Adamg159/powerunit-research/photos/2026-08-15-heatshrink-bracket-testers-buzzers.jpg

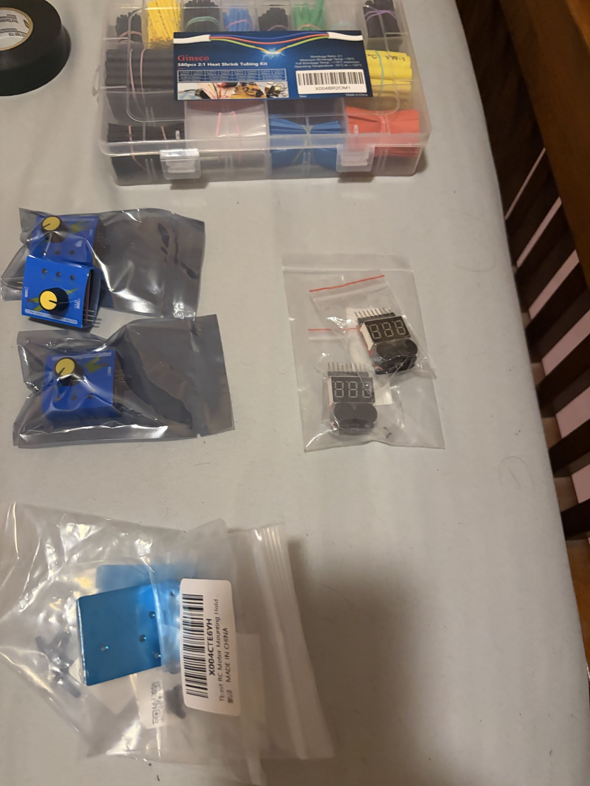
photos/2026-08-15-heatshrink-bracket-testers-buzzers.jpg
