Adamg159/powerunit-research/photos/2026-07-24-electronics-unboxing.jpg

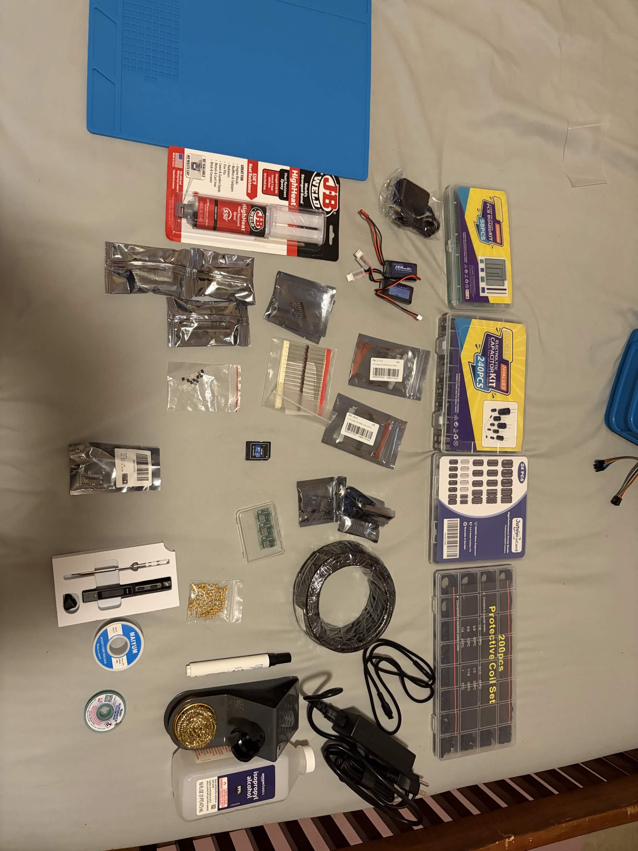
photos/2026-07-24-electronics-unboxing.jpg
