Adamg159/powerunit-research/README.md

# PowerUnit Research

Working repository for a 1/10-scale hybrid RC powertrain: a Toyan FS-L200AC 7cc
twin-cylinder four-stroke paired with a crank-mounted electric motor-generator
(F1 MGU-K style), managed by ESP32-based telemetry and energy management —
finishing in a self-designed 3D-printed chassis with instrumented aero. (A custom
ignition-timing ECU is a deferred stretch goal.)

Synced between desktop PC and laptop via this repo. Pull before working, push after.

**Status (2026-08-05):** engine on backorder until late August; build re-sequenced
to work around it (steering, MGU-K electrical, firmware, transmission, chassis
packaging, bench surrogate rig). See [CLAUDE.md](CLAUDE.md) for the governing plan.

## Contents

| File | What it is |
|---|---|
| [CLAUDE.md](CLAUDE.md) | Governing project context — architecture, current staged plan, decisions, open questions |
| [01-feasibility-proposal.html](01-feasibility-proposal.html) | Document 1 — feasibility assessment, three-phase plan, risks, budget |
| [02-phase1-status-and-arrival-plan.html](02-phase1-status-and-arrival-plan.html) | Document 2 — Phase 1 orders, arrival checklists, telemetry bill of materials |
| [03-build-companion.html](03-build-companion.html) | Document 3 — system walkthrough, wiring reference, EMI rules, study guide |
| [BUILD-LOG.md](BUILD-LOG.md) | Running log of progress, problems, and fixes — the portfolio deliverable |

Firmware source, wiring diagrams, and telemetry data will be added as the build progresses.
