Adamg159/powerunit-research/photos/2026-08-15-bench-set-all-items.jpg

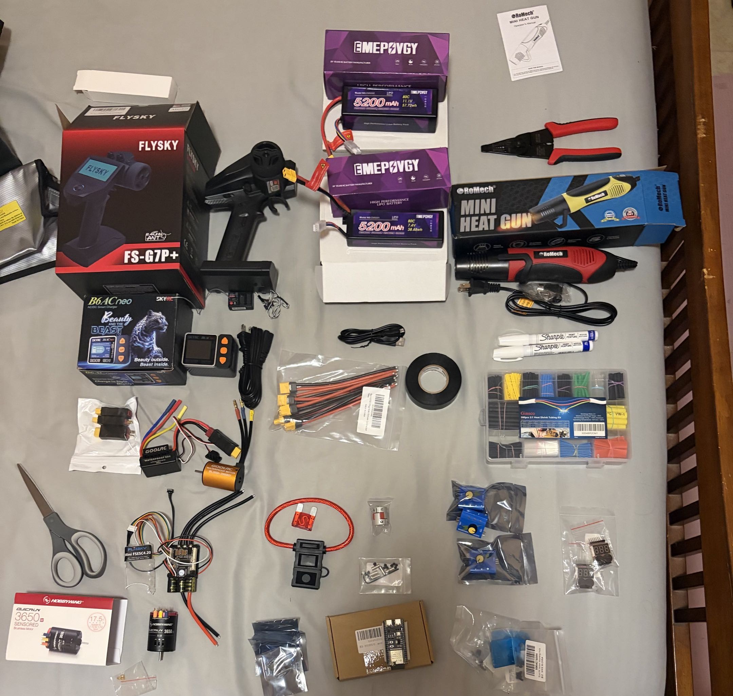
photos/2026-08-15-bench-set-all-items.jpg
