Adamg159/powerunit-research/photos/2026-08-15-charger-and-surrogate-combo.jpg

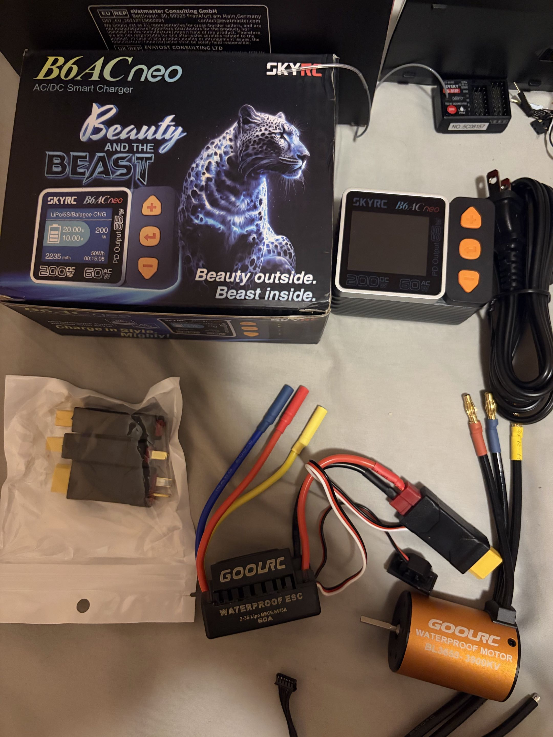
photos/2026-08-15-charger-and-surrogate-combo.jpg
