Adamg159/powerunit-research/photos/2026-08-15-esp32s3-bucks-fuse-coupler-sleeves.jpg

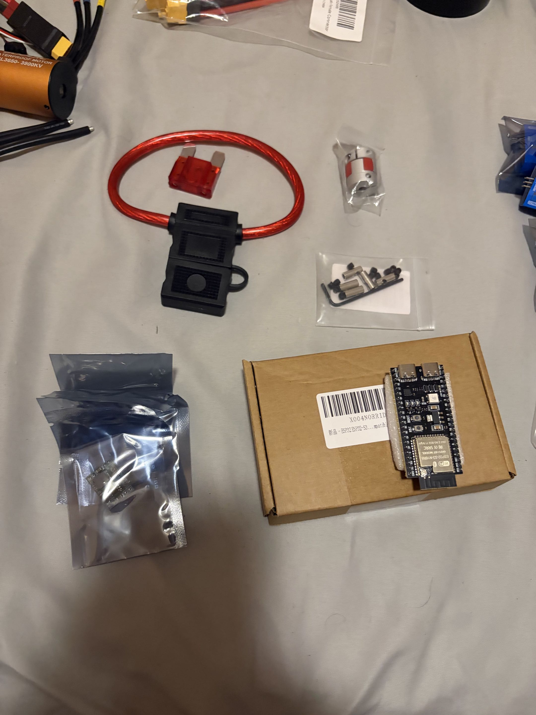
photos/2026-08-15-esp32s3-bucks-fuse-coupler-sleeves.jpg
