Adamg159/powerunit-research/photos/2026-08-15-heat-gun-stripper-tools.jpg

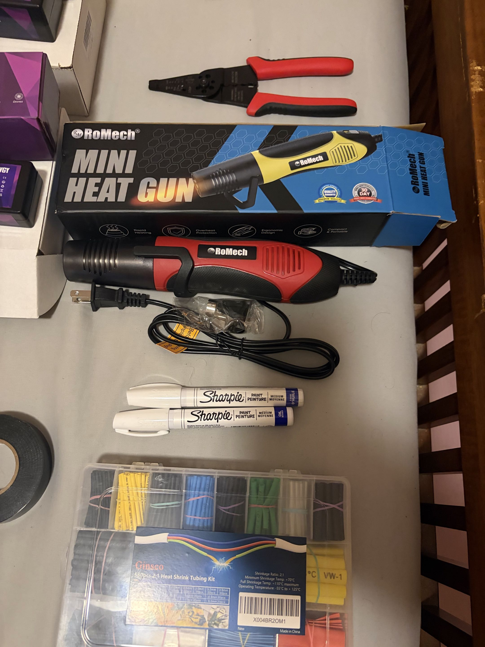
photos/2026-08-15-heat-gun-stripper-tools.jpg
