Adamg159/powerunit-research/photos/2026-08-15-lipo-packs-2s-and-3s.jpg

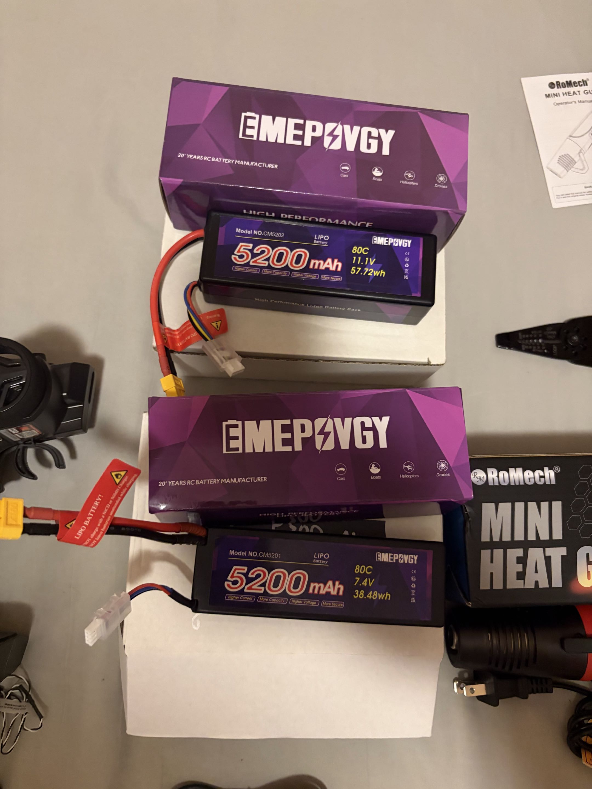
photos/2026-08-15-lipo-packs-2s-and-3s.jpg
