Adamg159/powerunit-research/photos/2026-08-15-lipo-safety-bags.jpg

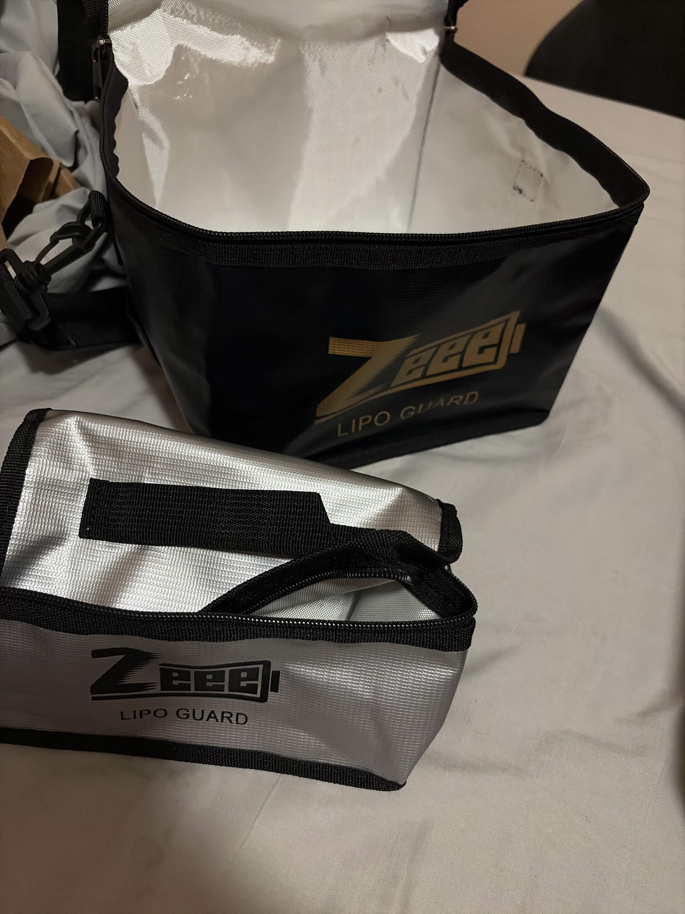
photos/2026-08-15-lipo-safety-bags.jpg
