Adamg159/powerunit-research/photos/2026-08-15-mgu-k-motor-and-vesc.jpg

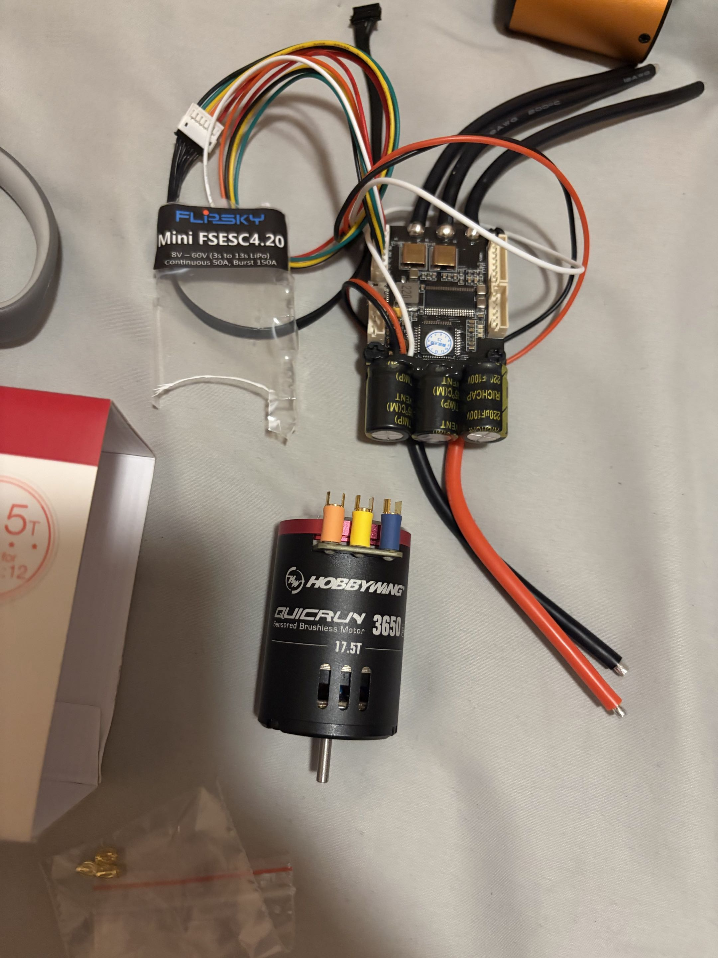
photos/2026-08-15-mgu-k-motor-and-vesc.jpg
