Adamg159/powerunit-research/photos/2026-08-15-radio-fs-g7p-and-receiver.jpg

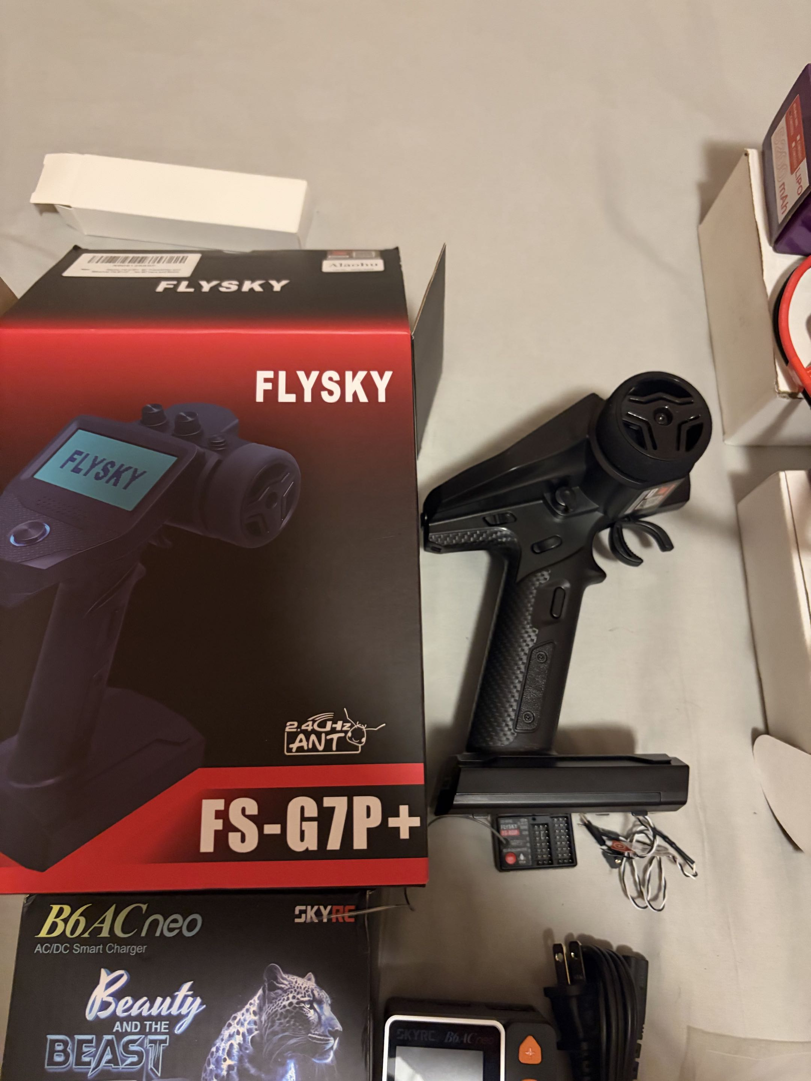
photos/2026-08-15-radio-fs-g7p-and-receiver.jpg
