Adamg159/powerunit-research/photos/2026-08-16-both-shafts-d-flats.jpg

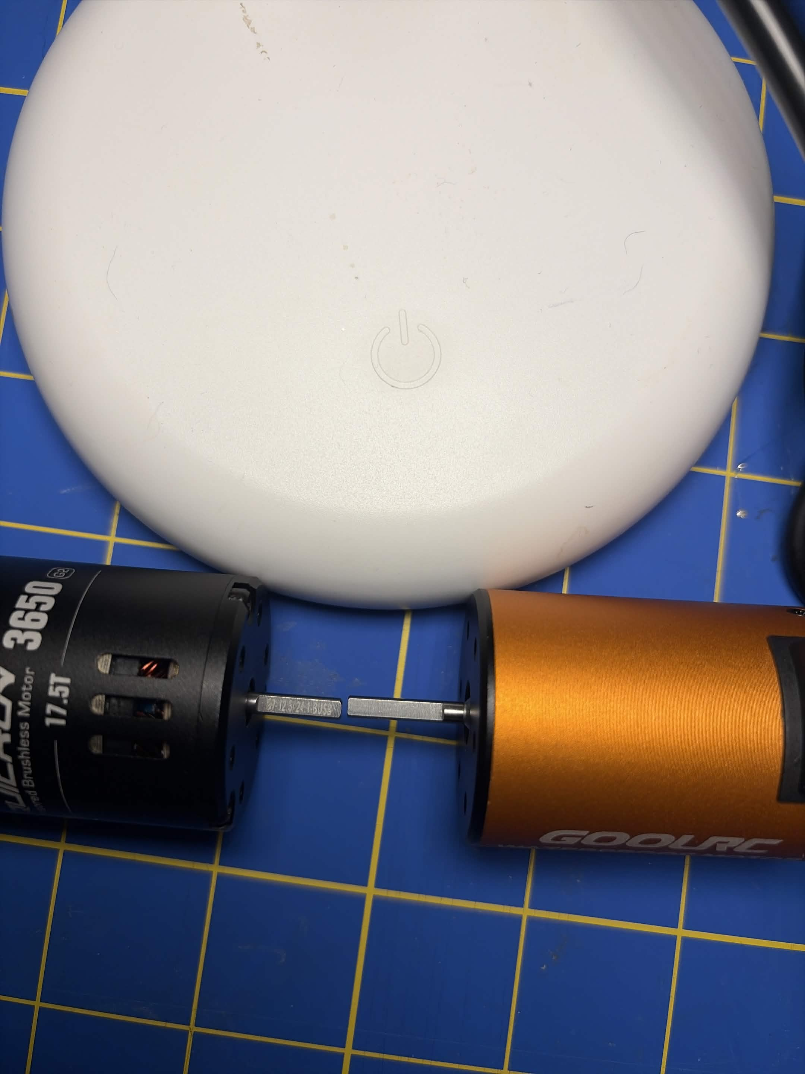
photos/2026-08-16-both-shafts-d-flats.jpg
