Adamg159/powerunit-research/photos/2026-08-16-first-3s-charge.jpg

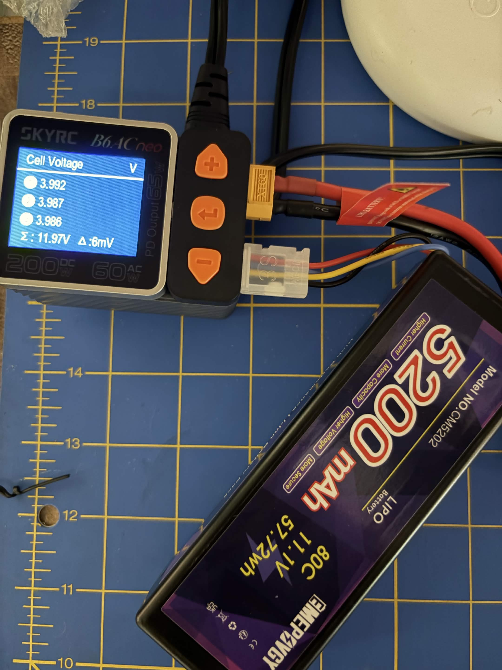
photos/2026-08-16-first-3s-charge.jpg
