Adamg159/powerunit-research/photos/2026-08-16-fs-r11p-top-labels.jpg

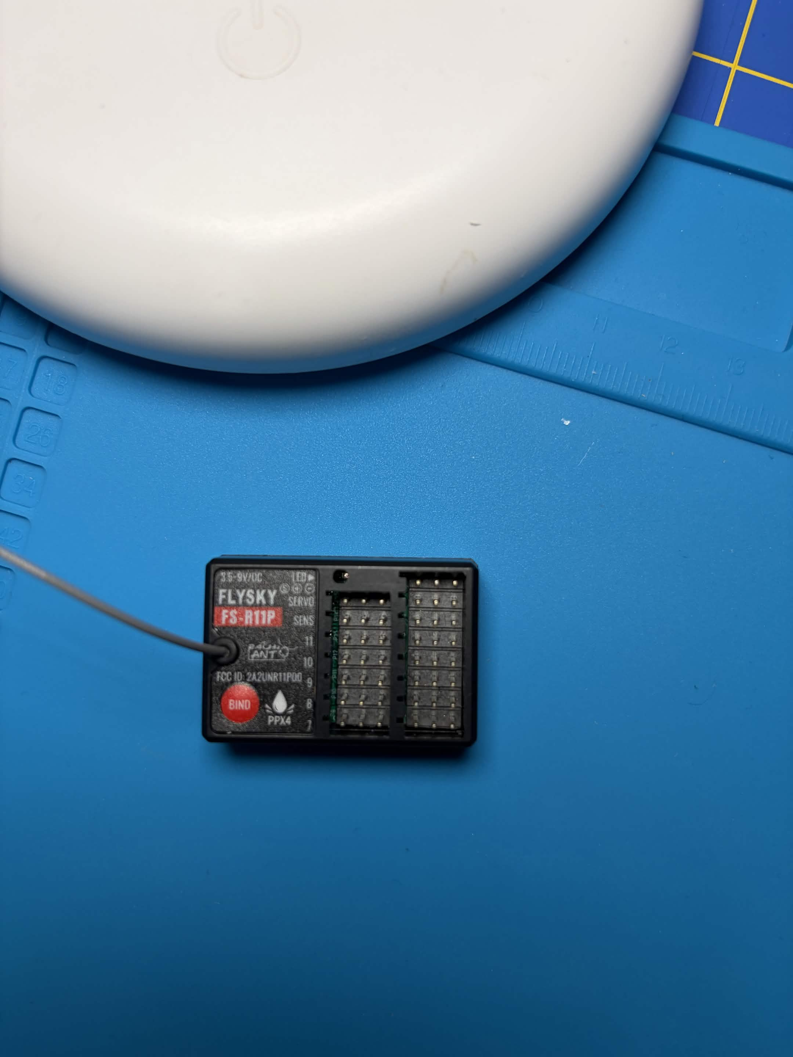
photos/2026-08-16-fs-r11p-top-labels.jpg
