Adamg159/powerunit-research/photos/2026-08-16-fuse-holder-wire-crosssection.jpg

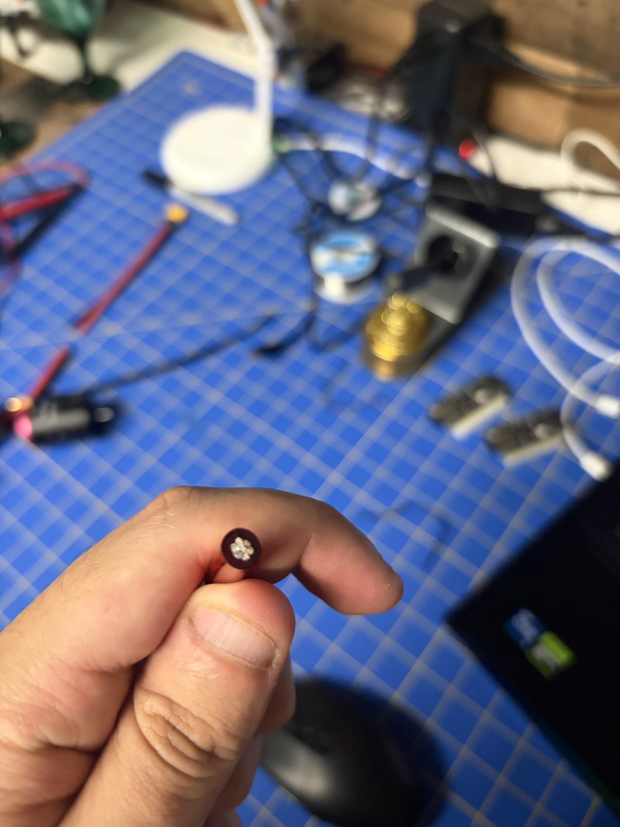
photos/2026-08-16-fuse-holder-wire-crosssection.jpg
