Adamg159/powerunit-research/photos/2026-08-16-motor-bracket-fitted-angled.jpg

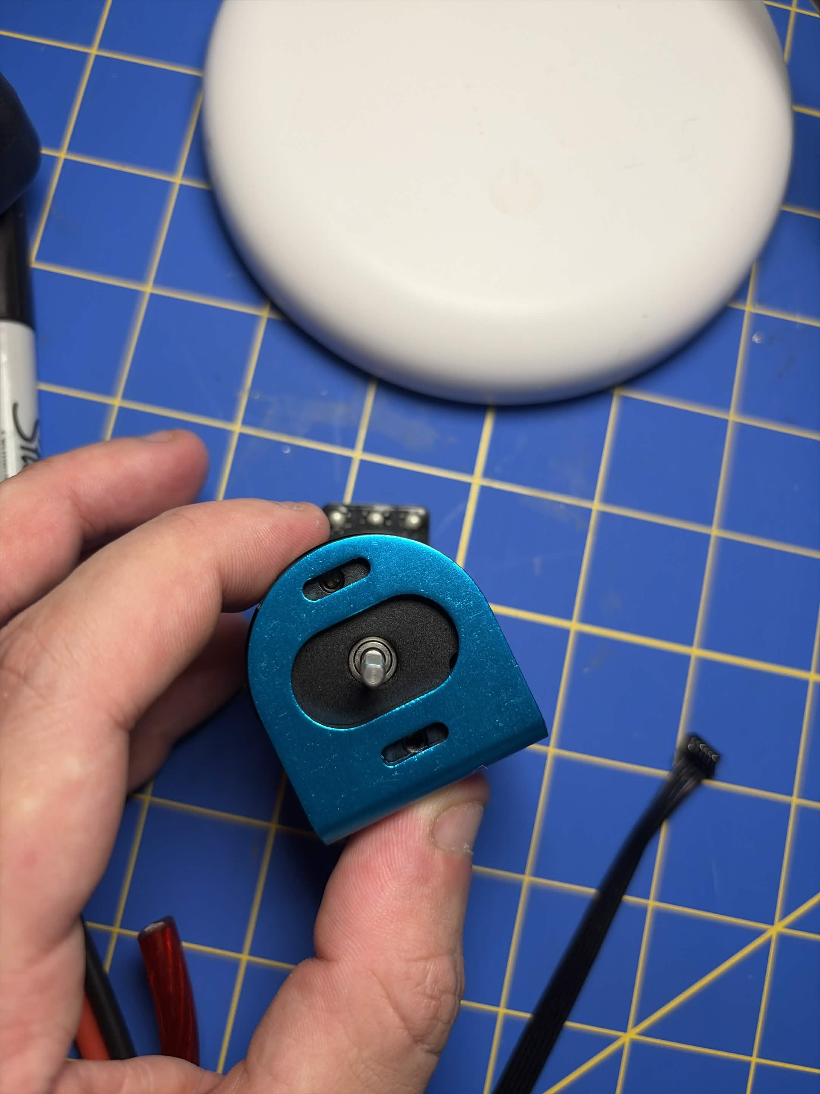
photos/2026-08-16-motor-bracket-fitted-angled.jpg
