Adamg159/powerunit-research/photos/2026-08-16-motor-can-label-and-bullets.jpg

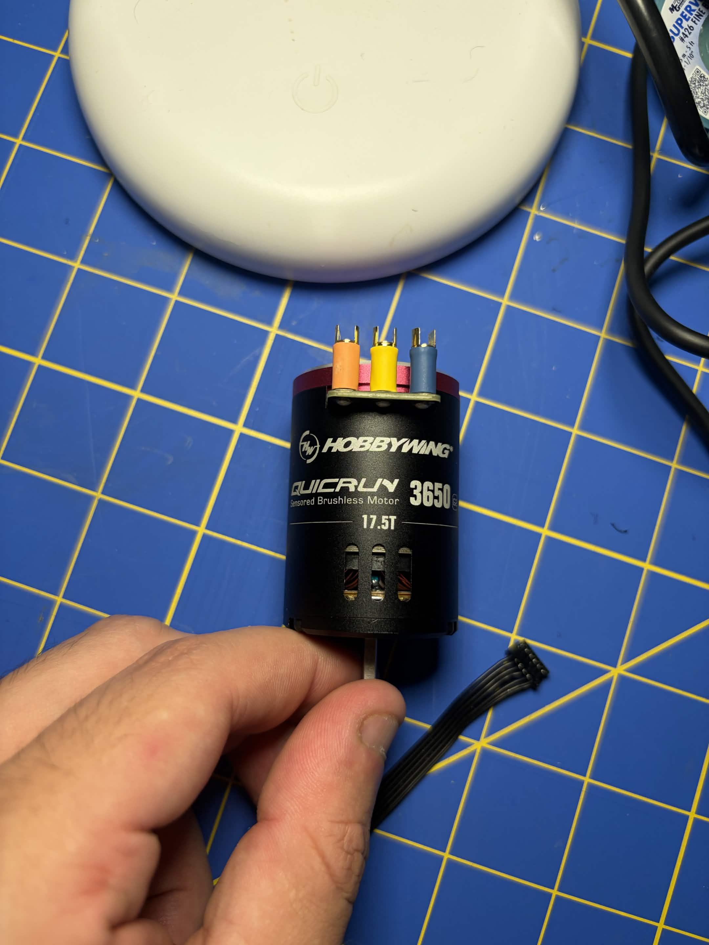
photos/2026-08-16-motor-can-label-and-bullets.jpg
