Adamg159/powerunit-research/photos/2026-08-16-motor-can-serial.jpg

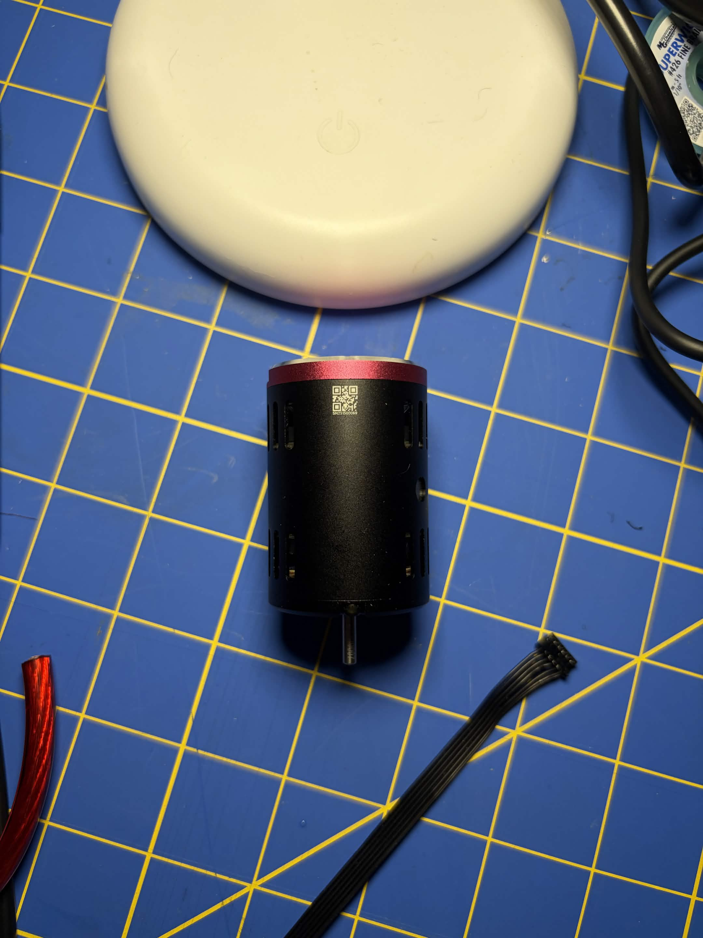
photos/2026-08-16-motor-can-serial.jpg
