Adamg159/powerunit-research/photos/2026-08-16-motor-endbell-abc-labels.jpg

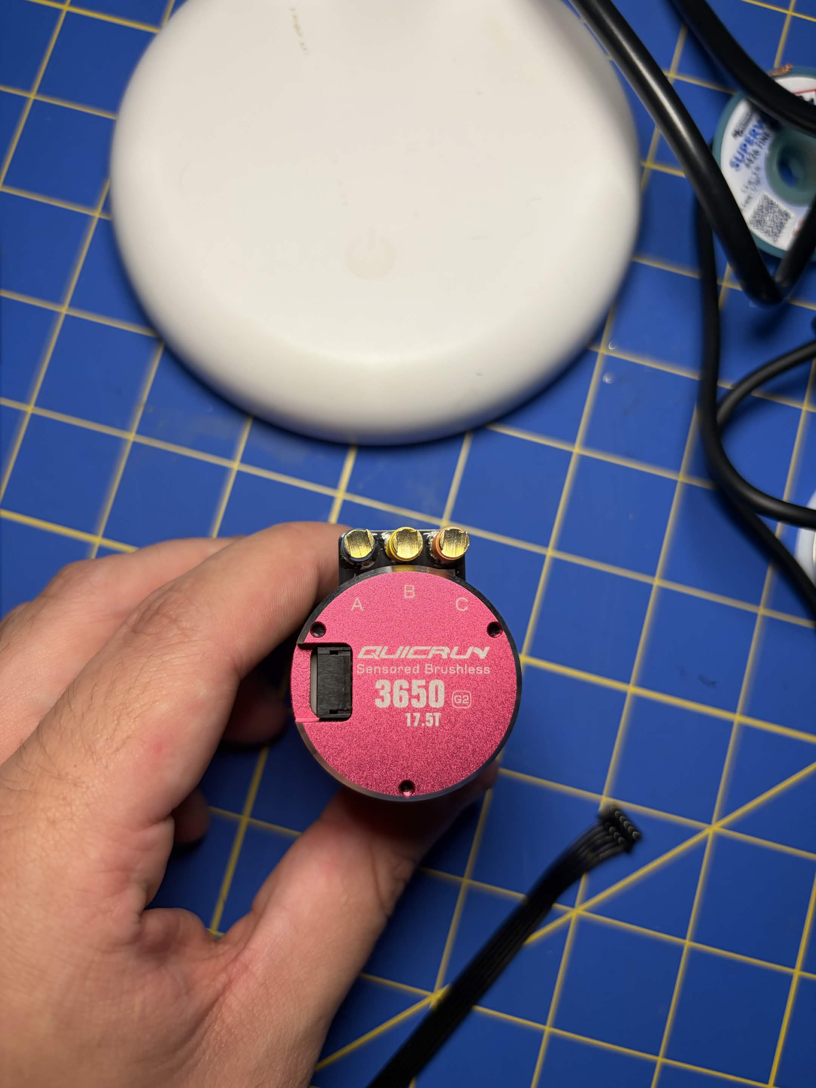
photos/2026-08-16-motor-endbell-abc-labels.jpg
