Adamg159/powerunit-research/photos/2026-08-16-motor-front-mounting-face.jpg

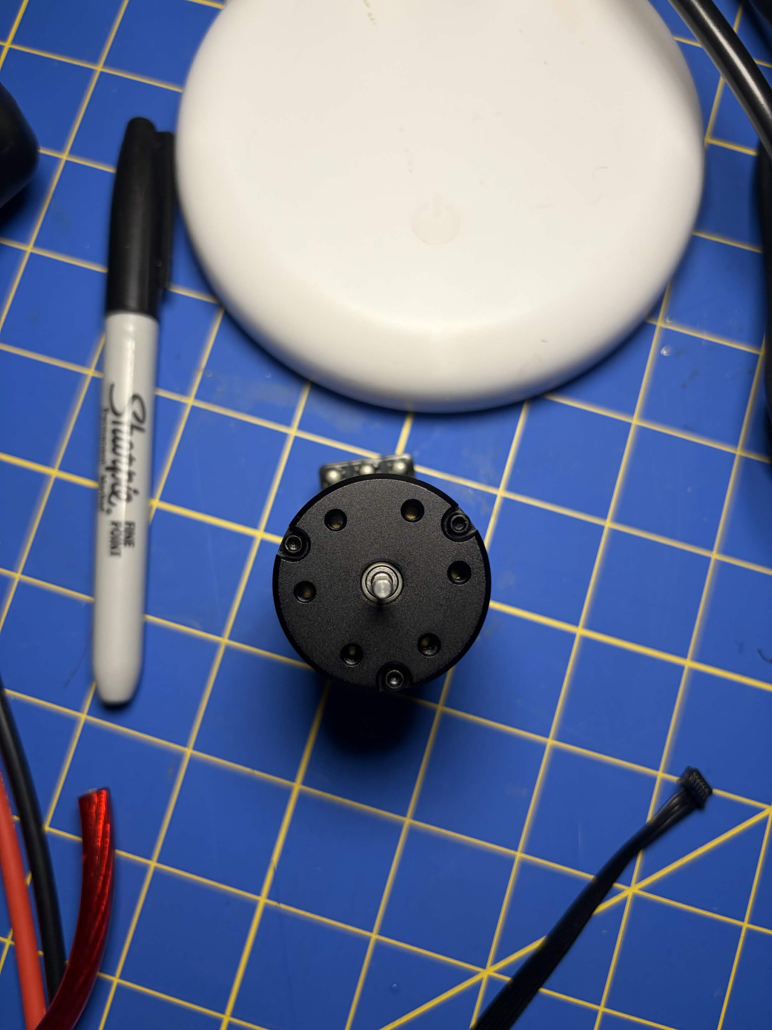
photos/2026-08-16-motor-front-mounting-face.jpg
