Adamg159/powerunit-research/photos/2026-08-16-motor-side-shaft-end.jpg

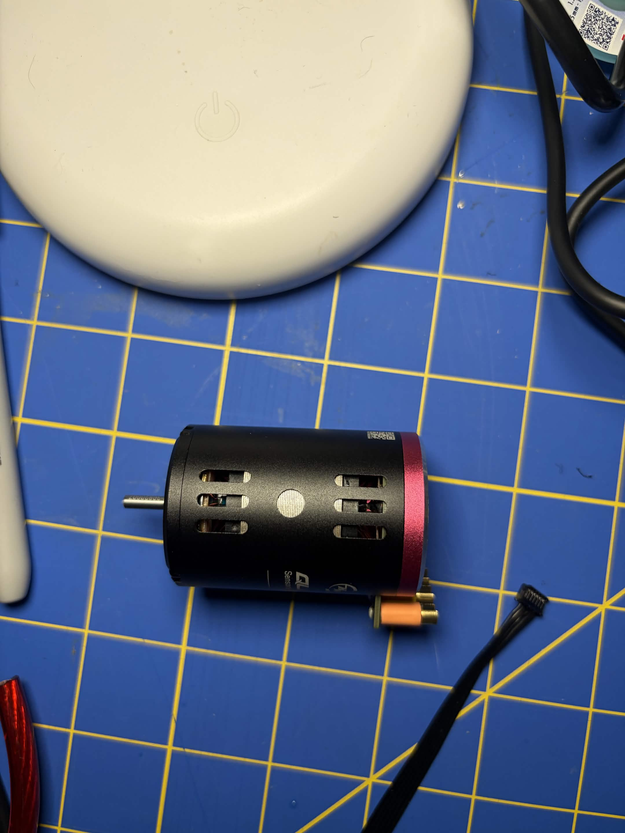
photos/2026-08-16-motor-side-shaft-end.jpg
