Adamg159/powerunit-research/photos/2026-08-16-sensor-cable-mated-joint.jpg

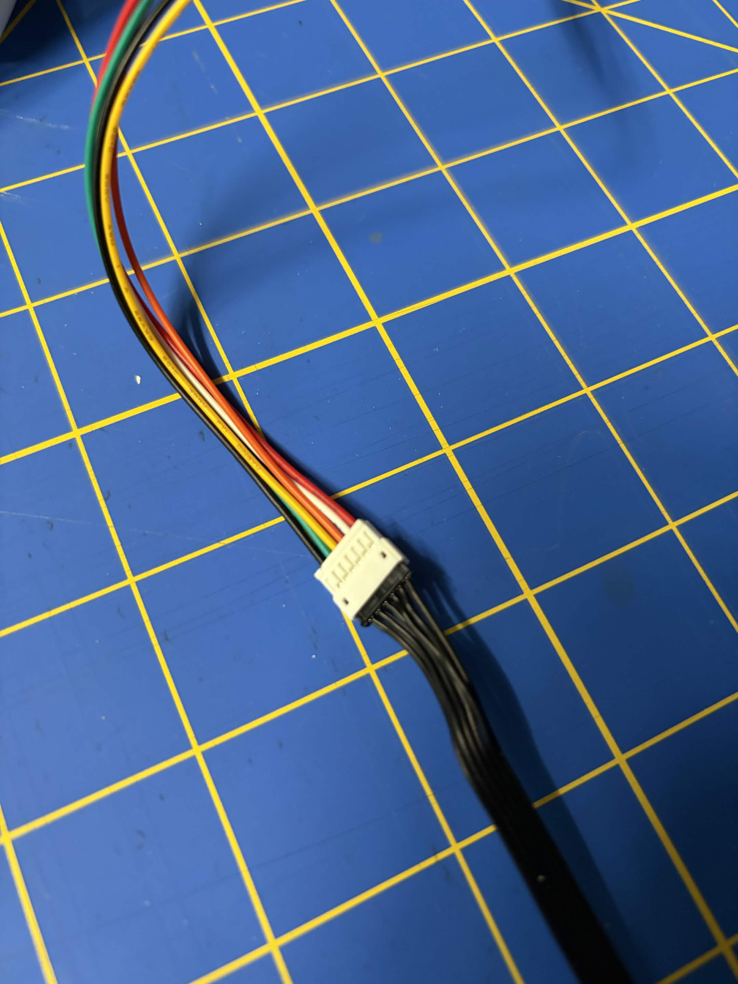
photos/2026-08-16-sensor-cable-mated-joint.jpg
