Adamg159/powerunit-research/photos/2026-08-16-sensor-path-full-chain.jpg

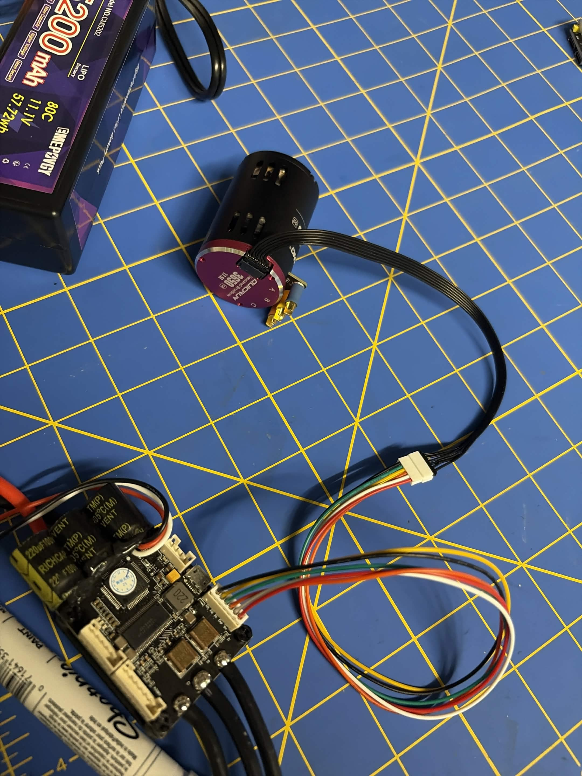
photos/2026-08-16-sensor-path-full-chain.jpg
