Adamg159/powerunit-research/photos/2026-08-16-sensor-path-motor-endbell.jpg

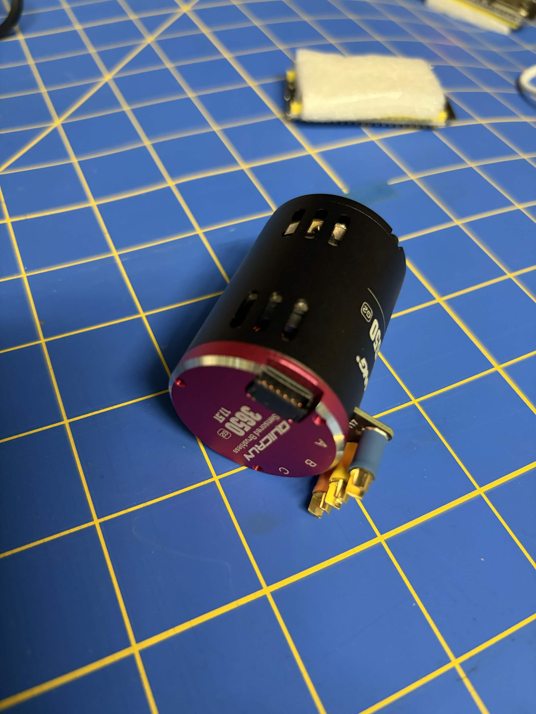
photos/2026-08-16-sensor-path-motor-endbell.jpg
