Adamg159/powerunit-research/photos/2026-08-16-vesc-ports-and-sensor-pigtail.jpg

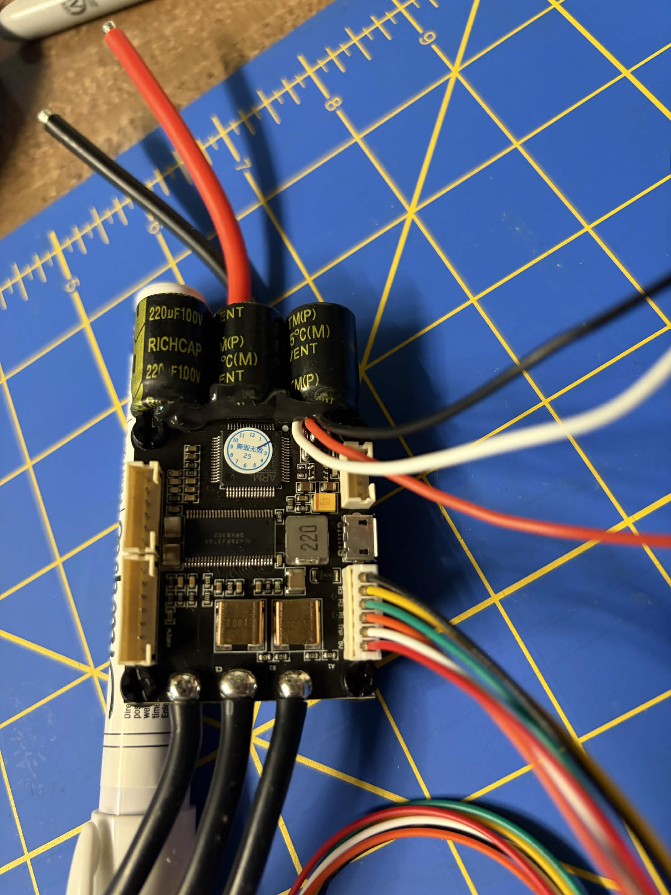
photos/2026-08-16-vesc-ports-and-sensor-pigtail.jpg
