Adamg159/powerunit-research/photos/2026-08-16-motor-manual-specs.jpg

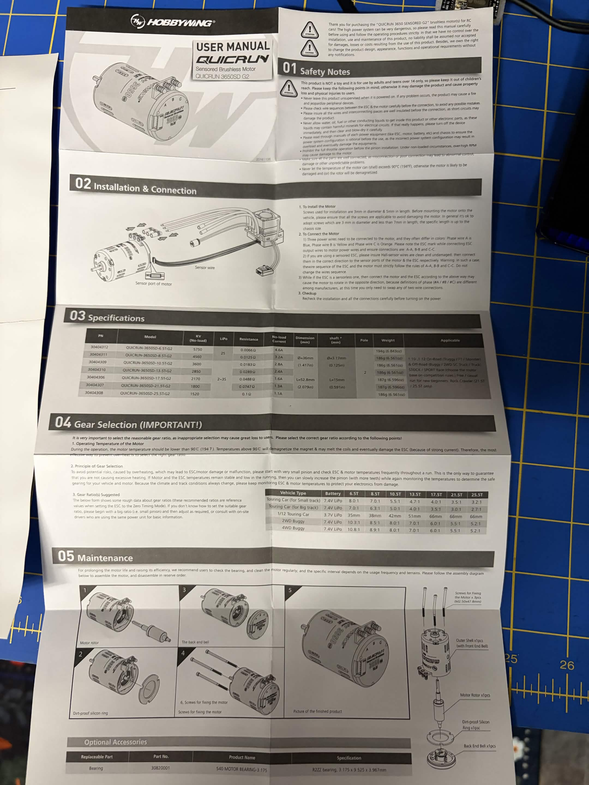
photos/2026-08-16-motor-manual-specs.jpg
