Adamg159/powerunit-research/photos/2026-08-16-power-path-pre-solder.jpg

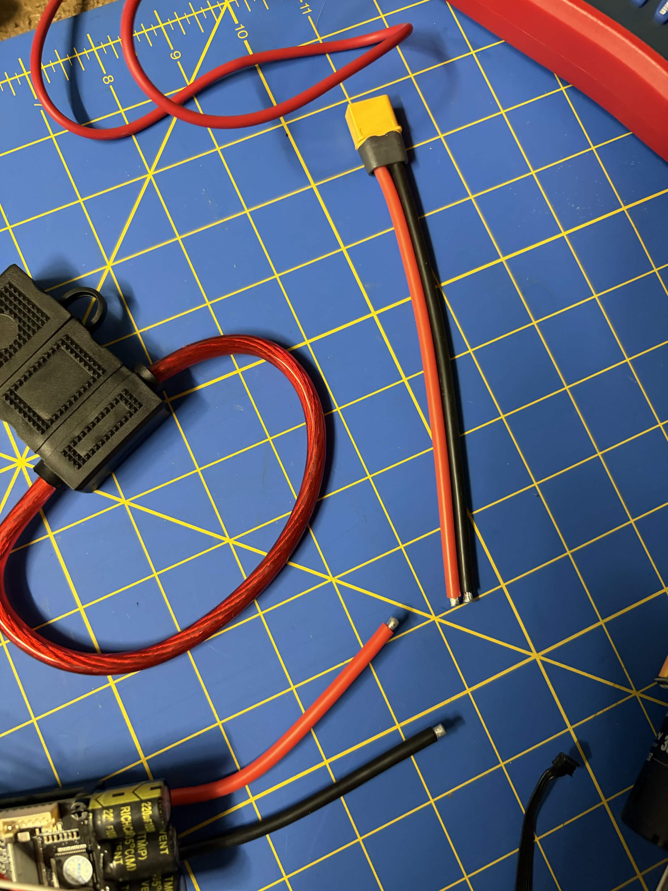
photos/2026-08-16-power-path-pre-solder.jpg
