Adamg159/powerunit-research/photos/2026-08-16-vesc-wiring-diagram.jpg

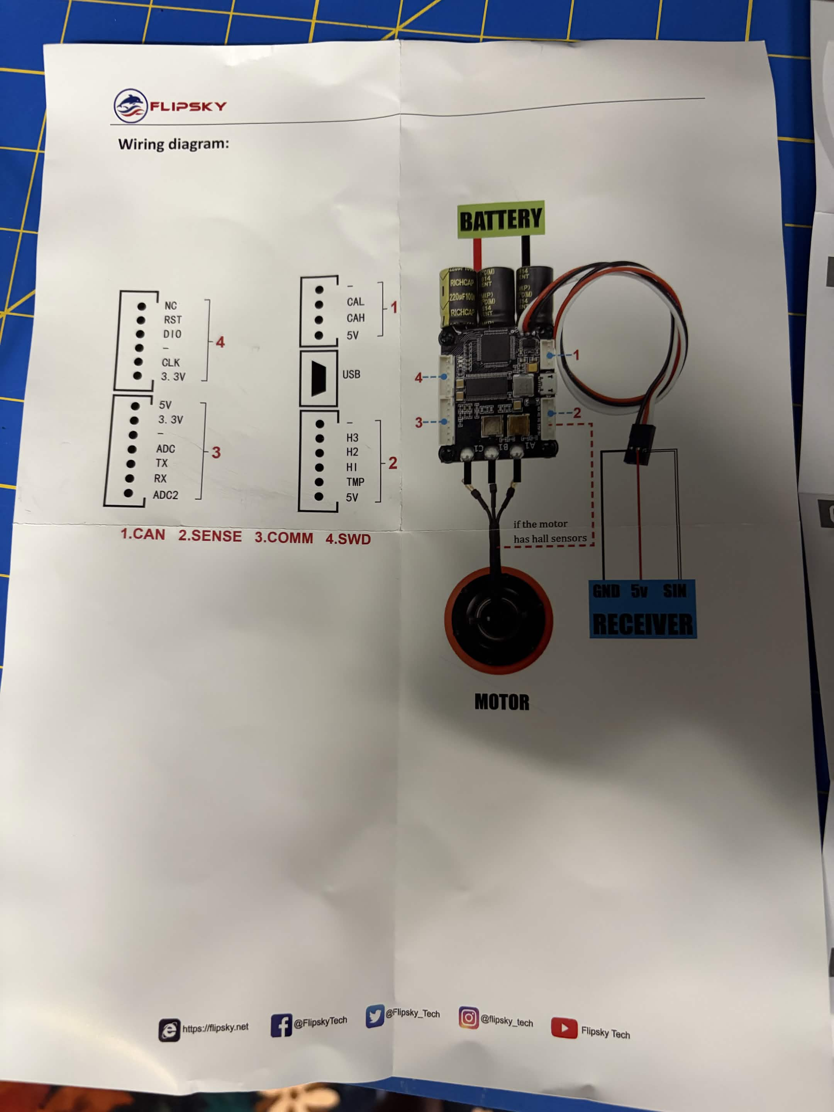
photos/2026-08-16-vesc-wiring-diagram.jpg
