Adamg159/powerunit-research/(commit log)

2026-07-25 Electronics arrival: all 3 ESP32s verified, arrival-test firmware added
    Arrival logged with delivery inventory (one MAX31855 and the SmCo magnets
    still in transit, neither blocking). All three ESP32 DevKits flashed and
    verified: genuine D0WD-V3, working WiFi, MACs logged for identification.
2026-07-25 Log multimeter gap: bucks blocked until it arrives
2026-07-25 Add clip leads to tooling order; note pigtail plan for buck setup
2026-07-26 Add sensor arrival-test sketches: MPU-6050, MAX31855, SD module, Hall
    All dependency-free (raw Wire/SPI or bundled SD lib), wiring documented
    in each header, clear PASS criteria over serial. Compile-verified.
    firmware/README.md indexes them with flash commands.
2026-07-26 Log JST-RCY pigtail order; battery connector identified
2026-07-26 Log SD module PASS: mounts at 10 MHz, write/append/read-back verified
    25 MHz failed on jumper wires as the sketch anticipated; the clock-ladder
    retry dropped to 10 MHz and mounted. Card reports 29.15 GB, matching the
    h2testw result.
    Also note the COM port is per-USB-port (COM8 this time, not COM4) and
    record the Arduino IDE board selection (ESP32 Dev Module).
2026-07-26 Log MPU-6050 PASS at 0x68; note default gyro range clips at 250 dps
    Accel magnitude 0.99-1.00 g at rest, gyro bias 1-3 dps, die temp ~28 C.
    AD0 pulls low on these GY-521 boards, so 0x68 needs no jumper.
    Also records two traps found along the way: the sketch prints a very
    plausible 36.5 C with nothing connected (Wire.read() returns -1 on an
    empty buffer), and the stock +/-250 dps full scale railed during hand
    handling and will saturate on a running engine.
2026-07-26 All 3 MPU-6050 boards soldered and verified; tick checklist item
    Headers soldered on all three GY-521 boards and each tested individually,
    all PASS at 0x68. Closes the arrival-checklist soldering item.
2026-07-26 Log MAX31855 PASS: cold junction 26.5 C, OC fault correctly set
    Fault register reads OC=1 with SCV=0 SCG=0 -- open circuit only, which is
    the expected result with no probe attached. The 2047.75 C reading is the
    14-bit field's positive rail, not data.
    Notes that the analog measurement path is still unverified; shorting T+
    to T- would exercise it before the washer thermocouples arrive.
2026-07-28 Log precision screwdriver + wire stripper/crimper orders
    Two bench tooling gaps found while setting up buck trim-pot tuning:
    - AXTH 25-in-1 precision screwdriver set (MP1584 pot needs ~1.5mm blade)
    - WGGE WG-015 wire stripper/crimper (20 AWG pigtails, 22-26 AWG sensor wire)
    Document 2 gains a "Bench hand tools" row plus the previously unrecorded
    JST-RCY pigtail line; document 3's buck checklist now spells out the full
    hookup.
2026-07-31 Log buck tuning: 2 of 3 MP1584s at ~5 V, third board fried; tick checklist
2026-07-31 Note cause of dead buck: accidental short during tuning
2026-08-05 Re-sequence plan around engine backorder; add governing CLAUDE.md
    Engine delayed 3-4 weeks (late Aug); CISON L4 swap declined. Staged-build
    plan merged into repo: bench surrogate approach, unblocked work lists,
    purchasing decisions (bench set authorized), ignition ECU deferred to
    stretch, MGU-K coupling open until vendor spec sheet, VESC UART is the
    current sensing. BUILD-LOG entry records the pivot and decisions.
2026-08-05 Answer round: RWD explicit, single-speed v1, one-way bearing risk flagged
    RWD recorded; single-speed transmission decided (energy-weighted regen
    math + RC two-speed one-way bearing kills the two-speed case); starter
    belt interface may freewheel - one-way check sent to top of vendor
    questions since it would zero out regen through the belt path; phased
    radio architecture (steering always RX-direct); surrogate motor moved
    from defer to buy after review (charge power path can't be validated
    free-spin, must not be first tested during engine break-in); shipping
    timeline recorded (magnets ~mid-Aug, kits with engine); lab PCB path
    added behind chassis packaging.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
2026-08-07 Size MGU-K electrical system (3S envelope); source and verify bench cart
    3S/11.1V system; Hobbywing QuicRun 3650SD G2 17.5T 2170kv primary after
    verification caught I*R deliverability gap in the 1900kv pick; no-BMS
    strategy (VESC limits + balance charging + MAXI fuse); surrogate combo
    + own 2S pack; two order blockers found (hall adapter, servo tester).
    Open decision flagged: Trampa MkVI ~$270 vs Flipsky 4.20 ~$60 (caps at
    ~350W). Cart ~$430-460 before VESC.
2026-08-08 Correct VESC ladder: sweep found two real mid-tier alternatives
    Four-corner market sweep (~40 products) disproved the no-mid-tier claim:
    Makerbase MINI V6.7 Pro is the one 6-class clone with an 8V floor, and
    the Trampa EDU was wrongly excluded on continuous-duty logic when this
    is a burst-duty application. Ladder rewritten in CLAUDE.md; probe-design
    note and escalation triggers logged. Flipsky Amazon channel identified
    (B08725X8CT, $71.99, in stock).
2026-08-08 Replace two adapter purchases with splice-from-owned-stock plans
    Hall adapter: splice motor and ESC included cables, map by function,
    halls land in any order (detection sorts), temp wire kept for NTC
    foldback. XT60-to-JST-RCY charge adapter: solder from owned pigtails.
    Kills a China-shipping order for a $1.80 wire.
2026-08-08 Log MGU-K motor order (#N892GD4DL, $63.08) and Amazon cart clearance
2026-08-08 Select radio system: Flysky FS-G7P+/FS-R11P; add radio setup reference
    Manual-verified simultaneous PWM + serial output, documented SBUS
    failsafe flags, per-channel failsafe. Y-lead dropped from Phase A
    (serial stream covers the ESP32 demand tap). docs/radio-setup.md
    carries wiring map, failsafe ritual, and bench acceptance tests.
    Purchase (~$86) pending approval.
2026-08-08 Verified gearing analysis: propose 40 km/h target; log radio order
    Rev-limited not power-limited; traction-limited launch; regen window
    corrected to top-half (clutch springs are the lever, not gearing);
    R ~4.9-5.0 on touring tires. Pitot needs SDP3x-class low-range DP
    sensor; crank-inertia spin-down added to bench list. Radio ordered
    $92.11 incl tax.
2026-08-08 Lock 40 km/h top-speed target; gearing R ~4.9-5.0 pending tire pick
2026-08-09 Log electrical tape purchase; flag missing heat-shrink for hall splice
2026-08-09 Log tooling/consumables order: shrink kit, heat gun, paint markers ($29.86)
2026-08-11 Log EngineDIY partial reply: crank nose 8mm shank / M6 thread
    Vendor supplied two dimensions instead of the requested spec sheet. Records
    the interpretation (stepped nose, standard nitro clutch mount), the torque
    sanity check showing the shaft is ~25x overbuilt while the M6 clamp is the
    tighter link, and what it unlocks: clutch bore now specified at 8 mm, and an
    off-the-shelf 8 mm to 3.175 mm coupler for the direct-mount branch.
    Mount design stays blocked. Rewrites the vendor follow-up as discrete
    questions (flat/keyway, shank and thread length, pitch and hand, taper,
    starter-end dimensions) since 'send the spec sheet' produced two numbers.
    The starter-belt freewheel question -- the actual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
2026-08-11 Web recon settles MGU-K coupling: starter pulley freewheels, direct crank mount forced
    14-agent web reconnaissance (6 modalities, 4 targeted diggers, 4 adversarial
    verifiers) run instead of waiting on EngineDIY. Headline: the factory manuals
    are public -- SEMTO ST-NF2 and OTTO FS-L200AC-OT are the same document under
    two brands, with a 60-line BOM and exploded views.
    Q1 RESOLVED/CONFIRMED: the one-way bearing is inside the crank-mounted start
    belt pulley (BOM item 37), so the crank cannot drive the starter belt. Zero
    brake regen and zero engine-driven charging via that path in v1 or v2. The
    belt route also fails independently on kinematics (~7:1 step-up would ask
    112k rpm of a 24k-rpm motor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
2026-08-11 Work today's recon back through the sensor plan
    Records five consequences for the telemetry work:
    - Never site the RPM magnet on the start-belt pulley: it holds the one-way
    bearing, so the crank outruns it once the engine fires and any pickup there
    reads garbage. Most attractive-looking location on the engine; would only
    have surfaced as an inexplicably wrong tach on the bench.
    - VESC RPM is promoted to primary crank tachometer now the coupling is rigid
    and the motor is sensored; the A3144 + SmCo path stays as the independent
    cross-check that survives firmware or UART failure.
    - Adds wheel speed to the telemetry scope. It was missing, and the mandated
    regen-slip cut has no second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
2026-08-11 Close stale radio-gear open question (ordered Aug 7, delivered Aug 10)
2026-08-11 Close stale VESC-tier open decision: Flipsky ordered Aug 7, delivered Aug 10
    CLAUDE.md still framed the controller choice as pending in two places, but the
    Flipsky Mini FSESC4.20 was Adam's call and shipped in the bench-set order. The
    ladder is retained as the upgrade path rather than an open decision, and the
    MGU-K electrical item is restated as bench work.
2026-08-11 Close brake decision, specify wheel-speed sensing, move MCU to ESP32-S3
    Brake: active, on a DEDICATED servo, RX-direct permanently. Catches a trap in
    the plan's own wording -- the 'standard nitro two-servo layout' it pointed at
    puts throttle and brake on one servo, so Phase B would have handed the ESP32
    the brake along with the throttle. Three servos instead; costs zero ESP32 pins
    since brake demand comes off the SBUS stream. Inboard disc on the driveline,
    hardware deliberately not ordered until the transmission is picked.
    Wheel speed: two A3144 sensors on different axles so clutch slip and tire slip
    are separable. Records the open-collector wiring gotcha (power at 5V, pull up
    to 3.3V -- no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
2026-08-11 Select ESP32-S3 board; revert wheel-speed sensing to on-hand parts
    Wheel speed: Adam pushed back on buying Hall sensors and magnets when there
    are leftovers in stock, and he is right. Reverts to use-what-we-have, with the
    three checks that actually decide it recorded -- bare chips vs KY-003
    breakouts, field strength at the real air gap (the only genuine risk), and
    magnet count. Adds a note to prefer small magnets on the wheels to avoid
    rotating imbalance.
    MCU: all three candidate boards turned out to be the same ESP32-S3-WROOM-1
    N16R8 dual Type-C board, two of them the same DORHEA product in different
    pack sizes. Picked the Hosyond 3-pack on its explicit genuine-Espressif-module
    claim, DORH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
2026-08-11 Consolidate purchase record into doc 2; log ESP32-S3 order and sent clutch email
    Doc 2 held the only as-ordered record in the repo and covered just the 21 July
    telemetry order -- everything bought since existed only in BUILD-LOG. Adds a
    new Section 5 with all 20 lines of the 7-11 August powertrain and bench-set
    buying (~$533 as paid), each row carrying the reasoning behind the pick rather
    than just the price, plus the two blocked lines (clutch, brake) and what each
    is waiting on. Sections renumbered 5->6, 6->7.
    ESP32-S3 ordered: Hosyond 3-pack N16R8, $20.22 incl. tax, arriving 15 Aug.
    Added to the Section 4 telemetry BOM with the pin-budget rationale.
    Also strikes the earlier suggestion to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
2026-08-11 Close bench rig location; document rig safety rules
    Location settled: wall-anchored wooden desk, rigid enough that coupler runout
    won't walk two motors at ~30,000 rpm.
    Reframed the guarding spec after running the numbers. Fragment risk is
    negligible (~0.5 J if a coupler lets go), so the guard needs to block reach,
    not catch debris -- the real hazards are entanglement of probe leads or
    clothing, and the 58 Wh in a 3S 5200 mAh pack. Guard must be anchored and
    reach-blocking; probe-lead routing decided before spin-up; disconnect sited
    away from the coupler.
    Adds a hard rule for a non-combustible surface under all charging and pack
    rest, since the desk is wood. Records that the B6ACneo is powe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
2026-08-12 Log EngineDIY clutch bounce; name single-gear variant, re-send questions
    EngineDIY replied asking which of the six bell variants the questions
    referred to. Named the Single-gear Clutch and re-framed the bore/keyway
    and CDI-trigger-magnet questions as flywheel-side, so they should be
    answerable without another round trip.
    Records the belt-pulley variants as rejected for MGU-K drive: their
    pulley sits downstream of the shoes, so it loses drive whenever the
    clutch disengages.
2026-08-13 Log EngineDIY round 2: keyway closed, magnet conflict sharpened
    Keyway concern is dead: the notch is not the crank interface. The bore
    number is still unanswered after two rounds, and their description of the
    fit raised a better question about what carries the torque.
    The magnet answer was sideways. The trigger magnet lives on the CDI kit's
    own larger flywheel, not the stock one, so three flywheels now compete for
    the crank nose instead of two. Coexistence with the clutch is still
    unconfirmed and remains the purchase blocker.
    Also records EngineDIY's single-V-groove recommendation and why we pushed
    back: belt slip would present as clutch slip to the regen slip-cut.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
2026-08-14 Log EngineDIY video reply: clutch + CDI magnet flywheel coexist, demonstrated
2026-08-14 Identify video as V-groove variant; re-derive single-gear pick; unblock clutch order
2026-08-14 Log clutch order: single-gear variant, $25.20
2026-08-14 Open chassis packaging: working doc, mass budget v0, layout pre-analysis
2026-08-14 Power-module study: 1:1 rim belt drive wins, rear module envelope frozen
2026-08-16 Sequence bench bring-up; find second safety gate (no guard exists)
    Ordered procedure for the delivered bench set. Sequencing on paper surfaced
    that the rules-mandated reach-blocking guard was never bought -- it was
    described as free/improvised, so it silently failed to exist -- and that it
    gates VESC motor detection, not just the coupled rig.
2026-08-16 Close both safety gates; detail VESC bring-up and limit-proving stages
    Extinguisher delivered; venue moved to a bench with guarding, sand and tile.
    Stages 5-6 expanded into a bench-usable procedure. Two findings: VESC reports
    ERPM (pole pairs = 2), so the regen slip-cut needs an explicit divide-by-2 or
    it compares crank speed against wheel speed at 2x; and there is no graceful
    high-voltage regen taper, only a fault threshold, so regen sessions must start
    at <=4.0 V/cell rather than relying on the 4.15 V charger ceiling.
2026-08-16 Add tested slip-cut firmware module; write full next-steps list
    Driveline.h holds the single ERPM -> mechanical RPM conversion (VESC reports
    ERPM, pole pairs = 2) plus the Hall PulseTach and the regen SlipMonitor.
    Arduino-free and clock-injected so it runs as a desktop test: 30 checks, 0
    failures under -Wall -Wextra.
    Cut is on SIGNED slip -- crank leading is normal engine drive, crank lagging is
    clutch slip under regen -- so a magnitude test would have fired constantly under
    acceleration. Cut is immediate; re-allow needs cooldown plus a clean hold.
    Missing wheel data at speed fails closed.
    slip-cut-test runs the critical subset on-board at boot with no hardware, then
    gives a live two-tach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
    [slip-cut-test.ino]
2026-08-16 A3 done: 2 of 3 ESP32-S3 boards pass, board 2 defective
    Built arduino-cli 1.5.1 + esp32 core 3.3.11 toolchain. Working FQBN recorded,
    including the two traps: PSRAM=opi is mandatory or a good N16R8 reports zero
    PSRAM, and FlashSize=16M without a matching partition scheme strands 12MB.
    arrival-test made target-aware: the old sketch blinked GPIO 2 (S3 uses an
    addressable RGB) and never checked memory, which is the only thing that can
    catch a relabelled module. Now asserts 16MB flash / 8MB PSRAM.
    Board 2 (AC:27:6E:AA:C1:C4) boot-loops reading 0xffff at the partition table
    while the same bytes read back correctly over the programmer and persist across
    power cycles. Ruled out PSRAM mode, flash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
    [arrival-test.ino]
2026-08-16 Cancel sensor-cable splice; open the motor-NTC question in its place
    Photos show the Flipsky sensor cable mates the Hobbywing motor ribbon directly,
    so the 2026-08-07 splice plan and its $9 fallback kit are both deleted. The
    function-check survives: mating is not matching, and reversed 5V/GND kills the
    hall ICs silently.
    New question raised by the same photos: the 6th conductor is nominally the temp
    line but may be unpopulated. One meter reading at the motor connector settles
    it, and the motor-NTC foldback is what makes burst-duty assist an enforced
    limit rather than an intention.
    Also corrected: B2 needs no magnets, only B3 does.
2026-08-16 Fix pole count: 3650SD G2 is 2-pole (1 pole pair), not 2 pole pairs
    The Hobbywing manual spec table gives Pole = 2 for the whole family. With
    MOTOR_POLE_PAIRS = 2 the crank would have read half speed, looked permanently
    behind the wheels, and latched CutClutchSlip forever -- regen would never have
    engaged. Constant is now MOTOR_POLES = 2 with pole pairs derived, matching the
    units the manual prints and VESC Tool asks for. 33 desktop checks pass;
    corrected self-test re-verified on board 1.
    B2 done: slip-cut-test PASSes on hardware, and the live path demonstrates
    below-engagement vs CUT no-data on the same missing sensors.
    Also recorded from both manuals: 90C motor ceiling (sets foldback set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
    [slip-cut-test.ino]
2026-08-16 Record keyed sensor connectors and the deliberate 4.0V/cell charge stop
    Keying retires the reversal risk, so the A4 meter check drops from gate to
    quick confirmation -- keying fixes orientation, not pin mapping, so it is not
    dropped outright. Pack arrived at ~3.6V/cell and was charged to ~4.0 rather
    than 4.15 to preserve regen headroom.
2026-08-16 Add pack-connector and fuse step as a prerequisite past A4
    VESC ships with bare leads. Soldered XT60 plus the 50A MAXI fuse in the
    positive lead, both done while the wire is open. A taped joint survives a
    30-second milliamp measurement but not Stage 5: variable contact resistance
    heats at assist currents, and a joint that parts opens a live inductive bus --
    the load-dump mode the no-BMS decision exists to avoid.
2026-08-16 Resolve the iron question: owned TS101 is adequate, tip is the constraint
    Verified against BUILD-LOG 07-22/07-23. TS101 + 65W PD supply handles XT60,
    subject to reaching 20V (needs the 65W supply and a 3A cable) and a chisel tip
    rather than the stock fine conical -- tip thermal mass, not wattage, is what
    stops you dwelling long enough to deform the housing. Also noted the fuse makes
    this three joints rather than two.
2026-08-16 Pre-solder photo: XT60 is pre-leaded, add fuse-rating and CCA checks
    No cup soldering needed -- all three joints are wire-to-wire, so the melted
    housing risk is gone. Added checks that would each cost a rework: dry-fit the
    XT60 gender before soldering, confirm MAXI not ATC (ATC stops at 40A, so a 50A
    ATC fuse does not exist and a 40A one nuisance-blows during assist bursts), and
    check whether the holder tail is CCA rather than copper.
2026-08-16 A4 answered: motor NTC present (~10k), fuse confirmed MAXI 50A 32V
    The thermistor exists, so the manual's 90C ceiling becomes controller-enforced
    and the burst-duty argument has a mechanism rather than an intention. New
    follow-up A4b: beta is still unknown, and 3380 vs 3435 is ~10C apart at the
    setpoint -- too much blind error for a limit whose failure mode is permanent
    demagnetisation. Two-point R/T measurement, then cross-check against a MAX31855
    on the can during the first sustained runs.
    Fuse is correct on all three counts. Foldback setpoints fixed: start 70-75C,
    fully cut ~85C.
2026-08-16 Pin the NTC beta method to a water bath; note kit still to gather
    Heat gun drives the can surface ahead of the internal NTC, which puts the error
    straight into the beta calculation. A sealed-bag water bath makes the water
    temperature the motor temperature, so a kitchen thermometer is the only
    instrument needed.
2026-08-16 Close the CCA question on measurement; add fat-wire soldering guidance
    Fuse tail bundle measures ~2.6-3 mm (10-12 AWG equivalent), larger than the
    pack's own 12 AWG leads, so copper-vs-CCA stopped mattering -- ~1 mOhm over the
    tail either way. Recorded why colour cannot identify CCA, since the intuition
    is backwards: bare CCA looks like copper.
    The real consequence of that gauge is thermal mass at the joint, so the chisel
    tip is back to mattering and cold joints are the failure to watch for.
2026-08-16 A5 closes as N/A: motor is fixed-timing; file 16 photos from today
    Inspection found no timing scale, ring or clamp screws -- only the three
    through-screws. The manual sets timing in the ESC (Zero Timing Mode), and the
    exploded view lists no timing hardware. Adjustable end bells are a racing-line
    feature; QuicRun is the sport line, and the plan had carried a generic
    sensored-motor assumption since the motor was picked on 2026-08-07.
    Harmless: the drive/brake asymmetry argument belongs to trapezoidal ESCs. VESC
    FOC hall detection measures true sensor angles and compensates a static offset
    in both directions, so the Stage 5 calibration already delivers the symmetry
    regen needs. One prerequisit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
2026-08-16 A6: clocking angle is irrelevant to calibration; flag the missing 2nd bracket
    Rotating the motor about its own axis is invisible to VESC hall detection --
    sensors, rotor and stator rotate together, and detection measures that internal
    relationship, not orientation in the world. Clocking only decides where the
    bullets and sensor connector point, so pick for cable access. The bracket's arc
    slots are gear-mesh adjustment, not alignment.
    Real finding underneath the question: only one bracket was delivered, and
    Stage 7 couples both motors 1:1 on a rigid jaw coupler, which needs collinear
    shaft axes. A second identical bracket gives matched shaft height by
    construction. Logged as purchase D3b, no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
2026-08-16 Stage 7 mounting resolved: second bracket on hand, shared-base plan recorded
    Both brackets go on a common 2x4/plywood base, motors mounted after. Identical
    brackets on a shared flat face give matched shaft height by construction, which
    is the hard half of coupled-rig alignment. Purchase D3b closed unbought.
    Refinements recorded so they are not re-derived at Stage 7: verify the base is
    actually flat (lumber cups, and the matched-height argument assumes a common
    plane); use the coupler itself as the alignment gauge rather than a ruler; slot
    one bracket's holes so the alignment step has somewhere to go; identify whether
    the coupler is spider-type or rigid, since that sets the tolerance; throug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
2026-08-16 Correct the coupler-parts caption: those are shaft sleeves, not pinions
    The Aug 15 delivery photo was captioned from the photo rather than the packing
    list, and called the small parts "pinion/set-screw hardware". The 2026-08-07
    cart contains 3.175->5 mm sleeves and no pinions, and inspection confirms the
    parts have no teeth. Photo renamed to match.
    Also documents the coupling stack in the bring-up doc, since the mislabel had
    already caused one round of confusion: shaft 3.175 -> sleeve -> 5x5 jaw coupler
    -> sleeve -> shaft, 1:1 as the motor sizing assumed. Pinions belong to the
    transmission, which is still blocked on the tire pick and engagement RPM.
    Carries forward the two rules attached t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
2026-08-16 Shafts verified identical; defer filing flats and specify blue threadlocker
    Both shafts measure the same, so the sleeves work as bought and Stage 7 has no
    outstanding parts.
    Revises the blanket "file flats where the grub screws land" rule from
    2026-08-07. Design torque through the coupling is ~0.24 N.m, which a grub screw
    on a round 3.175 mm shaft carries on friction alone, and the MGU-K shaft has a
    future job -- the power-module study puts a 1:1 rim belt pulley on it at a
    position not yet chosen. Filing now would commit a feature to a location picked
    for a temporary bench coupler. Instead: witness-mark the joint and file only if
    it actually slips.
    Also clarifies that threadlocker goes on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
2026-08-16 Both shafts ship with a factory D-flat: retire the file-flats rule entirely
    Inspection of the parts shows both the MGU-K and surrogate shafts already carry
    a D-cut, which is standard on 3650 shafts for pinion grub screws. That retires
    the 2026-08-07 "file flats where the grub screws land" rule outright, and also
    retires yesterday's follow-on concern about committing a feature to a
    bench-chosen location -- the manufacturer cut it at the conventional spot, so
    the vehicle's rim-belt pulley will use the same flat.
    Replaced with the checks that actually matter: seat the grub screw on the flat,
    and verify the flat's ~5-8 mm length covers where the sleeve ends up, since a
    sleeve sitting past the f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
2026-08-17 Close out 2026-08-16: A6, coupling stack, and the day's standing lesson
    Files the both-shafts photo showing the factory D-flats run most of the exposed
    length, which retires the last caution about grub screws landing past a short
    flat.
    Adds the end-of-day entry: A6 clocking is irrelevant to calibration, Stage 7
    mounting resolved with the second bracket already on hand, the coupling stack
    corrected after the sleeves were mislabelled as pinions, and the file-flats rule
    retired outright.
    Names the pattern that repeated four times today -- pole count, sensor splice,
    end-bell timing, shaft flats -- all reasonable inferences from general RC
    practice, all wrong about these specific parts. Standin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
2026-08-17 Board #2 written off instead of returned; note the no-spare consequence
    RMA dropped as not worth the time. Records two consequences: mark the dead board
    physically before it leaves the bench, since it is visually identical to two
    good boards and its identifying MAC is only readable on a board that boots; and
    the project is now vehicle + bench with no spare, which is what the three-board
    buy existed to provide.
2026-08-17 Log AA + micro-USB order ($17.98): unblocks A2 and Stage 5 tomorrow
2026-08-21 A2: RX PWM reader replaces missing servos; FS-R11P port map read off the unit
    The acceptance tests assumed servos this project does not own. rx-pwm-test
    reads four channels in microseconds and reports how long after the last good
    frame each one reached its failsafe position -- the ~300 ms judgment time a
    servo cannot measure.
    The FS-R11P manual is only available as a corrupted scan, so the port map came
    from the unit's silkscreen: 3.5-9V/DC, an S/+/- legend printed on the case, and
    two banks. VCC is the supply; BVD beside it is battery-voltage detection, not a
    second input. Polarity is confirmed by continuity as well as by the legend,
    since reversed polarity kills receivers.
    Co-Authored-By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
    [rx-pwm-test.ino]
